GSAS-LABS/P.003/Images/Captura de Tela 2026-08-22 às 16.09.26.png

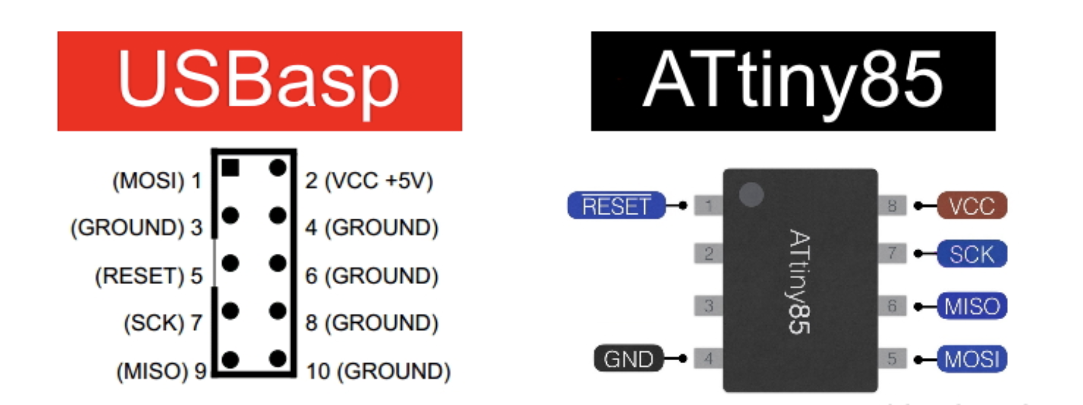
Images/Captura de Tela 2026-08-22 às 16.09.26.png
