GSAS-LABS/P.003/Images/pcb_soldered .png

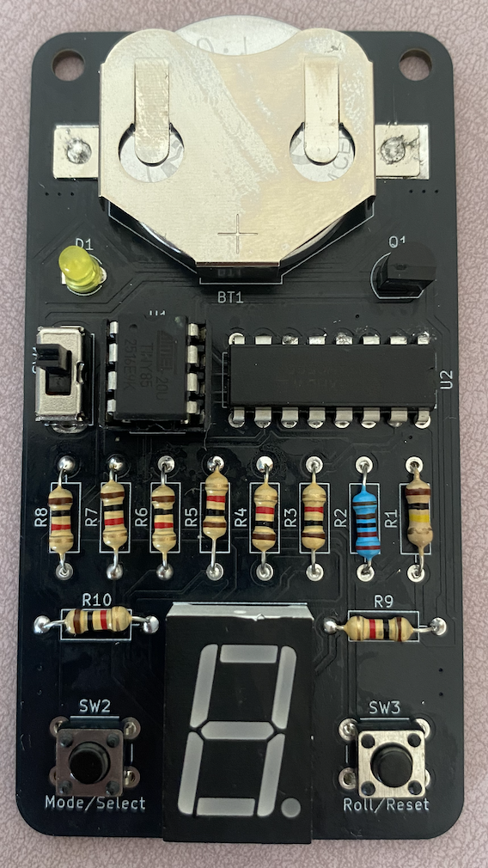
Images/pcb_soldered .png
