GSAS-LABS/P.003/Manufacturing/Test/board_test.pdf

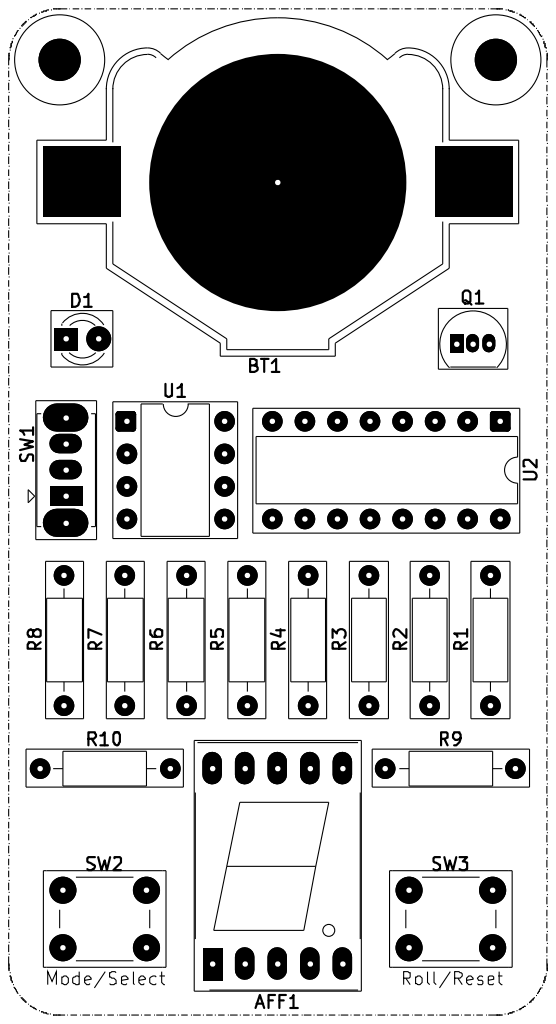
[picture p10: page 1]
