GSAS-LABS/P.003/P.003-V1.0.1/P.003-V1.0.1.kicad_pcb

## KiCad design P.003-V1.0.1/P.003-V1.0.1.kicad_pcb (2026-09-14)

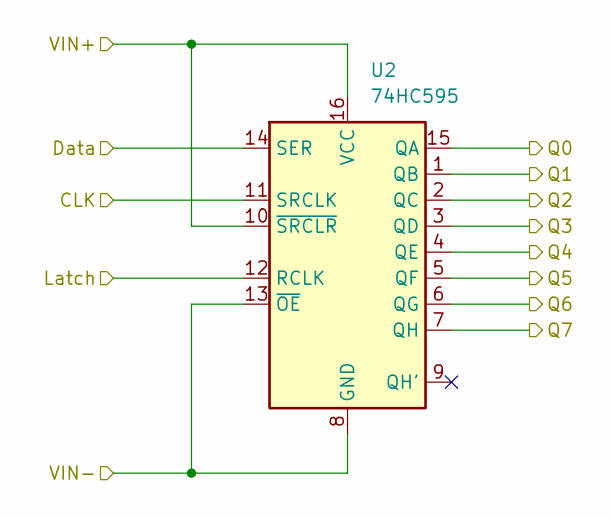
[picture p11: schematic shift_register_74HC595.kicad_sch, Shift Register - 74HC595]

Parts:
U2: 74HC595; DIP-16_W7.62mm

Connections:
/Attiny85/CLK: U2.11 (SRCLK); also elsewhere on the board
/Attiny85/Data: U2.14 (SER); also elsewhere on the board
/Attiny85/Latch: U2.12 (RCLK); also elsewhere on the board
/Attiny85/VIN+: U2.10 (~SRCLR), U2.16 (VCC); also elsewhere on the board
/Attiny85/VIN-: U2.8 (GND), U2.13 (~OE); also elsewhere on the board
/Display 7 Segment/Q0: U2.15 (QA); also elsewhere on the board
/Display 7 Segment/Q1: U2.1 (QB); also elsewhere on the board
/Display 7 Segment/Q2: U2.2 (QC); also elsewhere on the board
/Display 7 Segment/Q3: U2.3 (QD); also elsewhere on the board
/Display 7 Segment/Q4: U2.4 (QE); also elsewhere on the board
/Display 7 Segment/Q5: U2.5 (QF); also elsewhere on the board
/Display 7 Segment/Q6: U2.6 (QG); also elsewhere on the board
/Display 7 Segment/Q7: U2.7 (QH); also elsewhere on the board

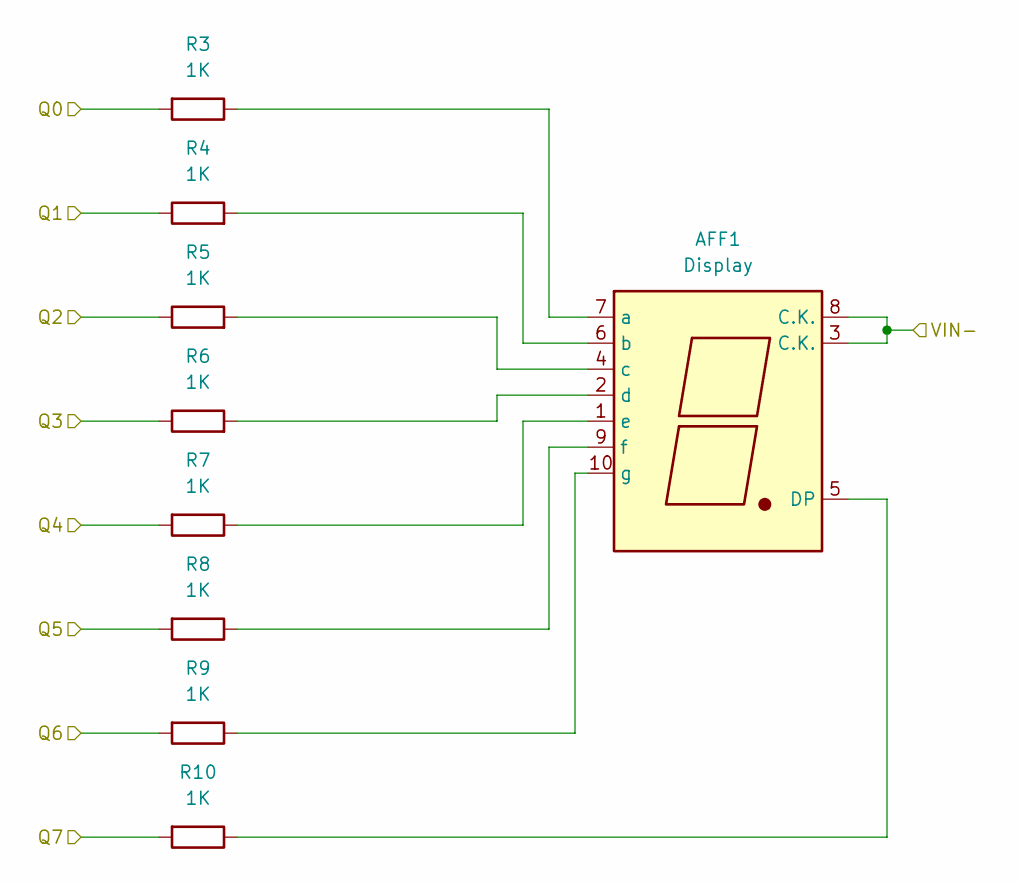
[picture p12: schematic 7_segment_display.kicad_sch, Display 7 Segment]

Parts:
AFF1: Display; 7SegmentLED_LTS6760_LTS6780
R3, R4, R5, R6, R7, R8, R9, R10: 1K; R_Axial_DIN0207_L6.3mm_D2.5mm_P10.16mm_Horizontal

Connections:
/Attiny85/VIN-: AFF1.3 (C.K.), AFF1.8 (C.K.); also elsewhere on the board
/Display 7 Segment/Q0: R3.2; also elsewhere on the board
/Display 7 Segment/Q1: R4.1; also elsewhere on the board
/Display 7 Segment/Q2: R5.1; also elsewhere on the board
/Display 7 Segment/Q3: R6.1; also elsewhere on the board
/Display 7 Segment/Q4: R7.2; also elsewhere on the board
/Display 7 Segment/Q5: R8.2; also elsewhere on the board
/Display 7 Segment/Q6: R9.2; also elsewhere on the board
/Display 7 Segment/Q7: R10.2; also elsewhere on the board
unnamed: AFF1.5 (DP), R10.1
unnamed: AFF1.7 (a), R3.1
unnamed: AFF1.6 (b), R4.2
unnamed: AFF1.4 (c), R5.2
unnamed: AFF1.2 (d), R6.2
unnamed: AFF1.1 (e), R7.1
unnamed: AFF1.9 (f), R8.1
unnamed: AFF1.10 (g), R9.1

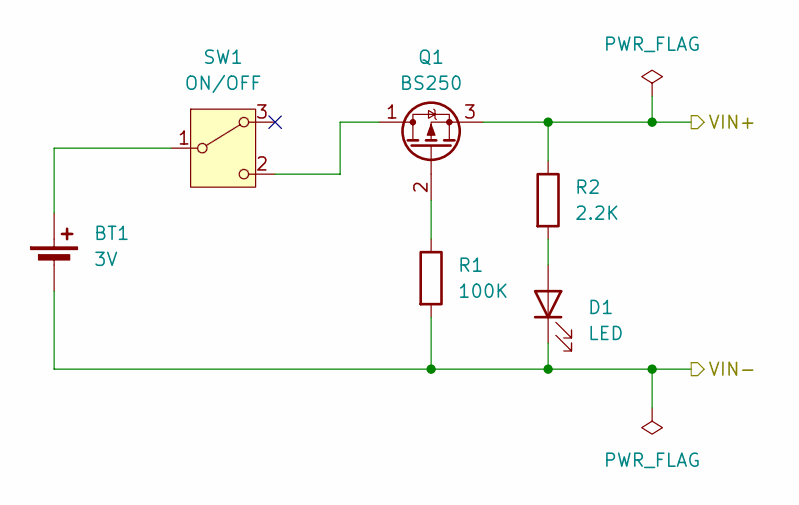
[picture p13: schematic power_supply.kicad_sch, Power Supply]

Parts:
BT1: 3V; BatteryHolder_Keystone_3008_1x2450
D1: LED; LED_D3.0mm
Q1: BS250; TO-92_Inline
R1: 100K; R_Axial_DIN0207_L6.3mm_D2.5mm_P10.16mm_Horizontal
R2: 2.2K; R_Axial_DIN0207_L6.3mm_D2.5mm_P10.16mm_Horizontal
SW1: ON/OFF; SW_Slide_SPDT_Straight_CK_OS102011MS2Q

Connections:
/Attiny85/VIN+: Q1.3 (S), R2.1; also elsewhere on the board
/Attiny85/VIN-: BT1.2 (-), D1.1 (K), R1.2; also elsewhere on the board
unnamed: BT1.1 (+), SW1.1 (B)
unnamed: D1.2 (A), R2.2
unnamed: Q1.1 (D), SW1.2 (C)
unnamed: Q1.2 (G), R1.1

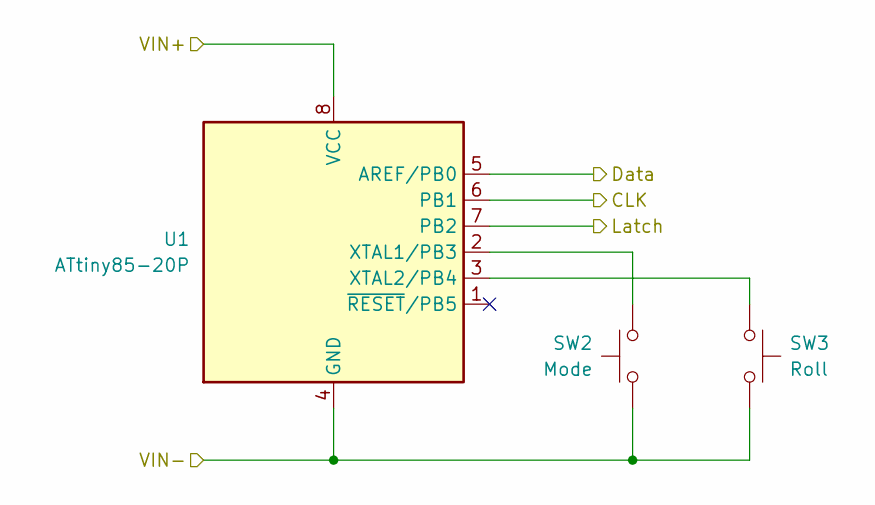
[picture p14: schematic attiny_85.kicad_sch, Attiny 85]

Parts:
SW2: Mode; SW_PUSH_6mm_H4.3mm
SW3: Roll; SW_PUSH_6mm_H4.3mm
U1: ATtiny85-20P; DIP-8_W7.62mm

Connections:
/Attiny85/CLK: U1.6 (PB1); also elsewhere on the board
/Attiny85/Data: U1.5 (AREF/PB0); also elsewhere on the board
/Attiny85/Latch: U1.7 (PB2); also elsewhere on the board
/Attiny85/VIN+: U1.8 (VCC); also elsewhere on the board
/Attiny85/VIN-: SW2.2, SW3.2, U1.4 (GND); also elsewhere on the board
unnamed: SW2.1, U1.2 (XTAL1/PB3)
unnamed: SW3.1, U1.3 (XTAL2/PB4)

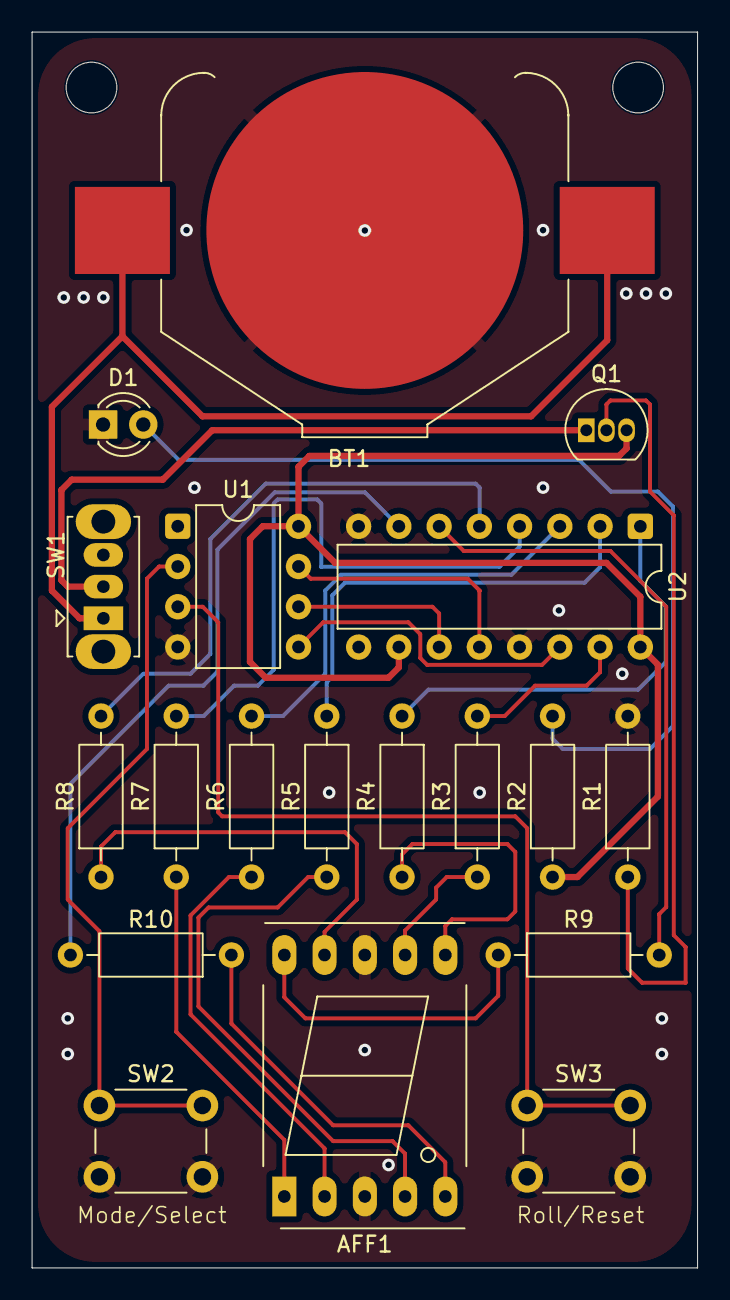
[picture p15: board P.003-V1.0.1.kicad_pcb from above]

Board: 2 copper layers, 42.0 x 78.0 mm, 19 parts (0 on the bottom side), 27 nets.
