GSAS-LABS/P.003/Attiny85/src/dice_attiny85.cpp

#include <Arduino.h>

#include "dice.h"
#include "buttons.h"
#include "display.h"
#include "power.h"

void setup() {
    displayBegin();
    buttonsBegin();
    powerBegin();
    diceBegin();
}

void loop() {
    diceUpdate();
}
