GSAS-LABS/P.003/(commit log)

2026-08-11 Test Arduino
2026-08-23 start kicad project
2026-08-23 add kicad
2026-08-23 Schematic wired
2026-08-23 add footprint
2026-08-23 add 3d and footprint
2026-09-10 add board_test
2026-09-19 Correct slide switch name in README
2026-10-10 Add 'Buy Me a Coffee' button to README
    Added a 'Buy Me a Coffee' section to support the project.
2026-10-11 README - Change button width from 180 to 120
    Updated the width of the 'Buy Me a Coffee' button in two instances.
2026-10-11 Increase button width in README.md
2026-10-11 Change button width from 140 to 130
    Updated button width in Buy Me a Coffee section.
2026-11-12 add Schematic
